JQIamo/Low-noise-5A-power-supply/README.md

# Low-noise-5A-power-supply
5A low noise +-15 V power supply for Eurocard boxes
