JQIamo/Low-noise-5A-power-supply/EurocardPowerSupply_mods.brd

## EAGLE design EurocardPowerSupply_mods.brd (2017-11-13)

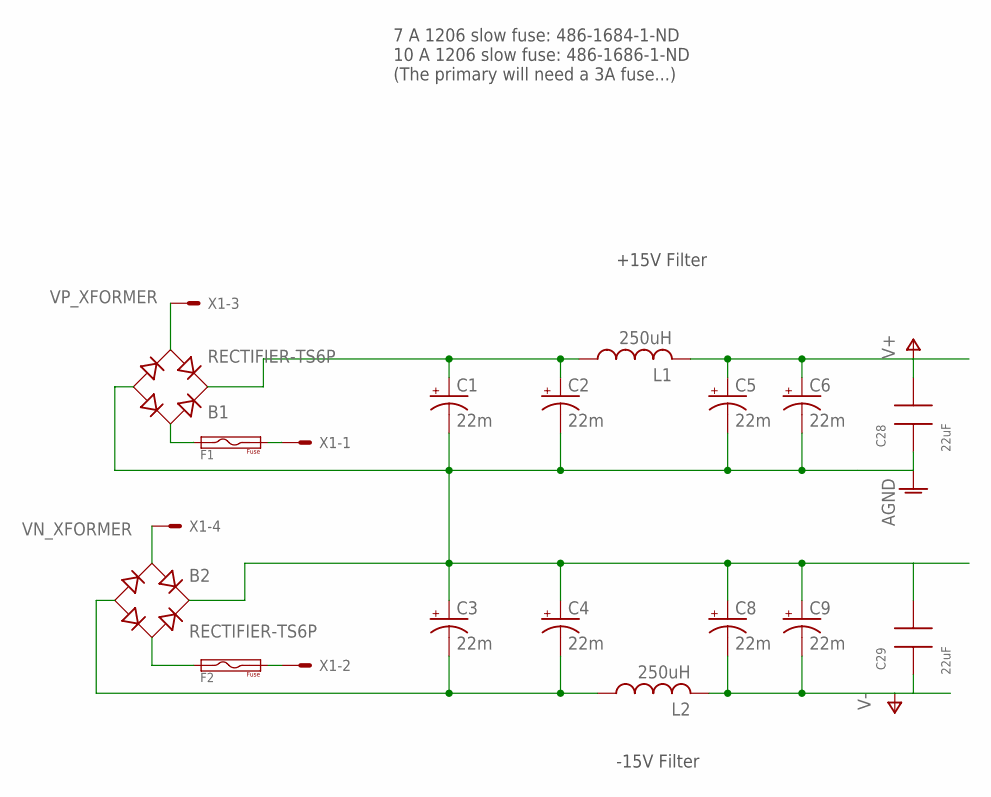
[picture p1: schematic EurocardPowerSupply_mods.sch, sheet 1]

Parts:
B1, B2: RECTIFIER-TS6P; TS6P
C1, C2, C3, C4, C5, C6, C8, C9: 22m; EB35D
C28, C29: 22uF; 1206; DIGIKEY 445-8045-1-ND
F1, F2: FUSE1206; DIGIKEY 486-1686-1-ND
L1, L2: 250uH; 5721-RC
X1: 5566-4

Connections:
AGND: B1.-, B2.+, C1.-, C2.-, C3.+, C4.+, C5.-, C6.-, C8.+, C9.+, C28.1, C29.2; also elsewhere on the board
unnamed: B1.AC1, F1.1
unnamed: F1.2, X1.1
unnamed: F2.2, X1.2
unnamed: B2.AC2, F2.1
V+: C5.+, C6.+, C28.2, L1.P$2 (2); also elsewhere on the board
V-: C8.-, C9.-, C29.1, L2.P$2 (2); also elsewhere on the board
VN_RECT: B2.-, C3.-, C4.-, L2.P$1 (1); also elsewhere on the board
VN_XFORMER: B2.AC1, X1.4
VP_RECT: B1.+, C1.+, C2.+, L1.P$1 (1); also elsewhere on the board
VP_XFORMER: B1.AC2, X1.3

Notes on the sheet:
-15V Filter
+15V Filter
7 A 1206 slow fuse: 486-1684-1-ND 10 A 1206 slow fuse: 486-1686-1-ND (The primary will need a 3A fuse...)

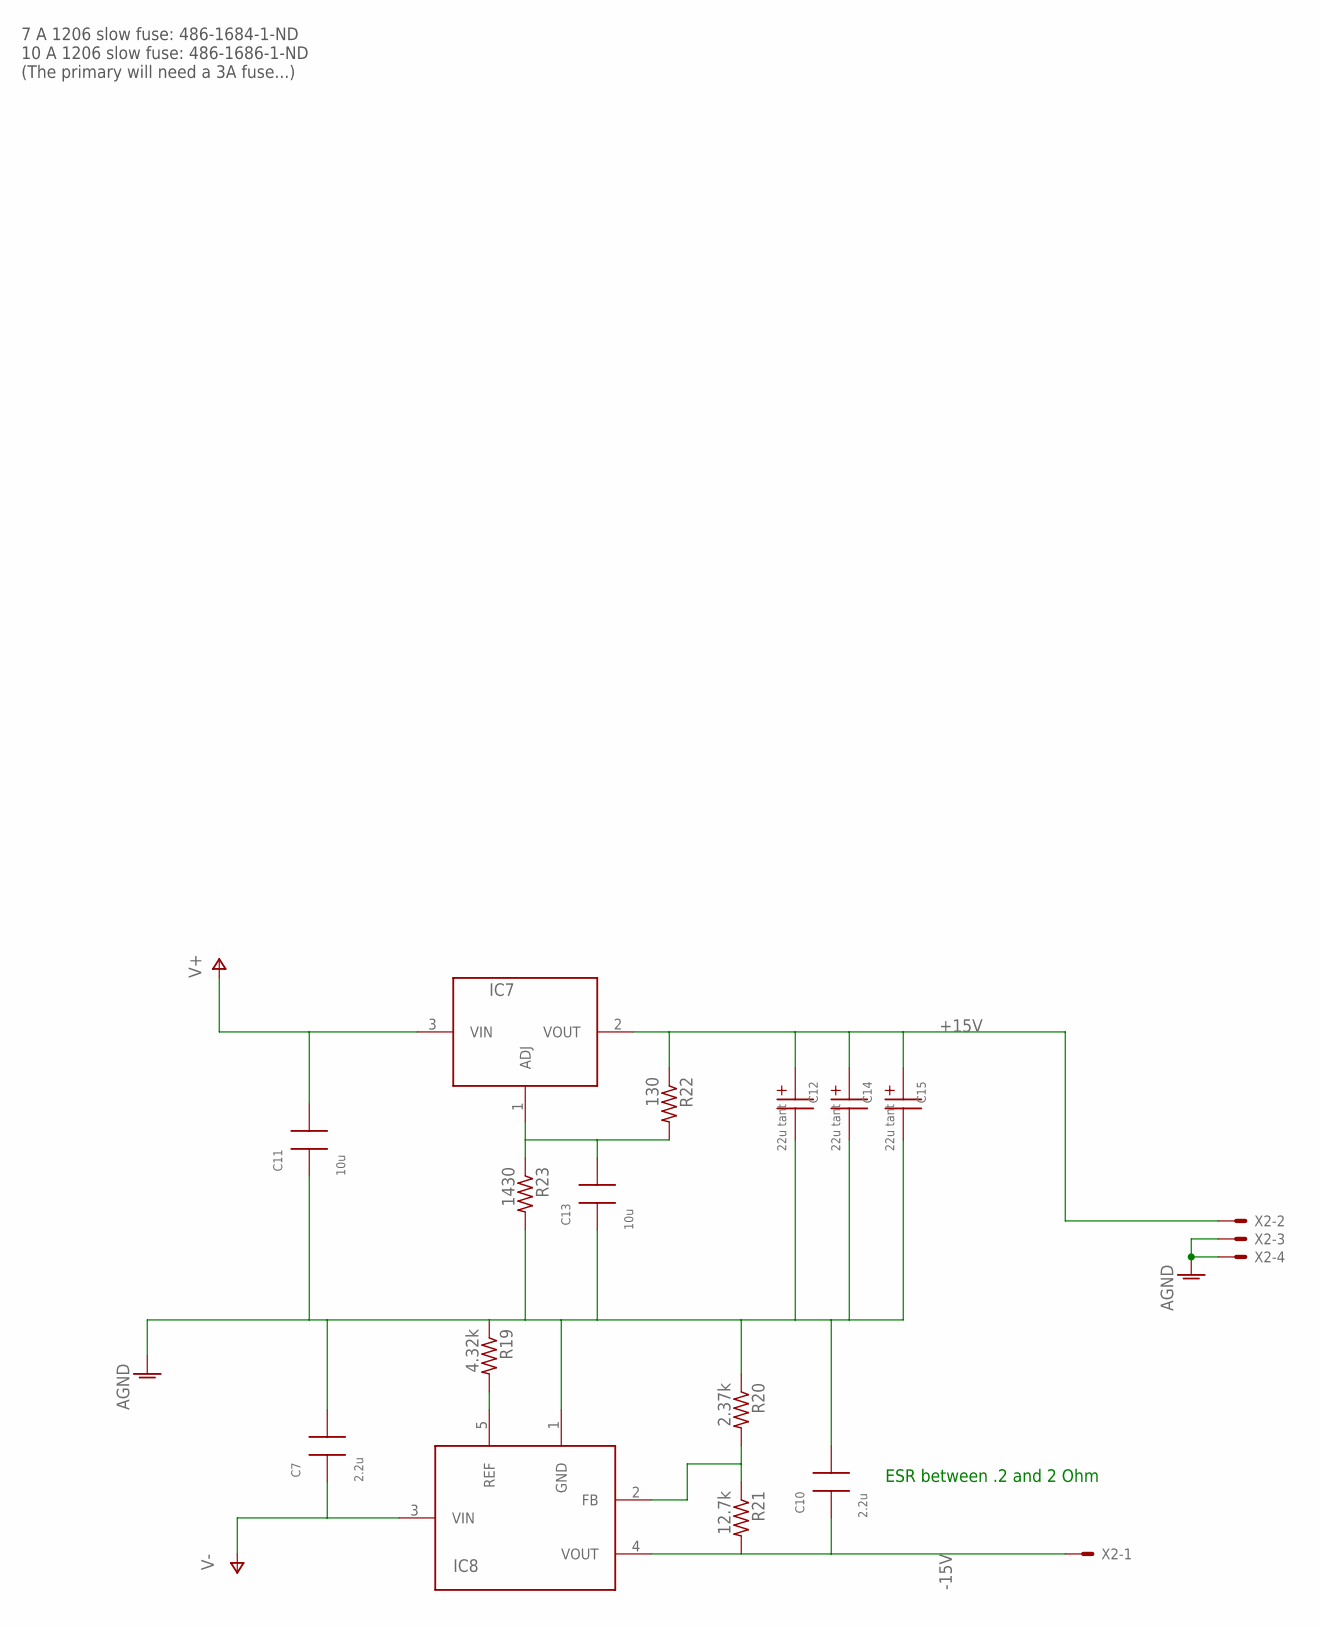
[picture p2: schematic EurocardPowerSupply_mods.sch, sheet 2]

Parts:
C7, C10: 2.2u; 1206; DIGIKEY 399-1249-1-ND
C11, C13: 10u; 1206; DIGIKEY 399-1249-1-ND
C12, C14, C15: 22u tant; 1206P; DIGIKEY 399-1249-1-ND
IC7: LM1084TO220; T03B
IC8: LT1185TO220/INLINE; T05A
R19: 4.32k; R1206; DIGIKEY 541-1.5KECT-ND
R20: 2.37k; R1206; DIGIKEY 541-1.5KECT-ND
R21: 12.7k; R1206; DIGIKEY 541-1.5KECT-ND
R22: 130; R1206; DIGIKEY 541-1.5KECT-ND
R23: 1430; R1206; DIGIKEY 541-1.5KECT-ND
X2: 5566-4

Connections:
+15V: C12.1, C14.1, C15.1, IC7.2 (VOUT), R22.1, X2.2
-15V: C10.1, IC8.4 (VOUT), R21.2, X2.1
AGND: C7.2, C10.2, C11.1, C12.2, C13.1, C14.2, C15.2, IC8.1 (GND), R19.1, R20.1, R23.2, X2.3, X2.4; also elsewhere on the board
unnamed: IC8.2 (FB), R20.2, R21.1
unnamed: C13.2, IC7.1 (ADJ), R22.2, R23.1
unnamed: IC8.5 (REF), R19.2
V+: C11.2, IC7.3 (VIN); also elsewhere on the board
V-: C7.1, IC8.3 (VIN); also elsewhere on the board

Notes on the sheet:
7 A 1206 slow fuse: 486-1684-1-ND 10 A 1206 slow fuse: 486-1686-1-ND (The primary will need a 3A fuse...)
ESR between .2 and 2 Ohm

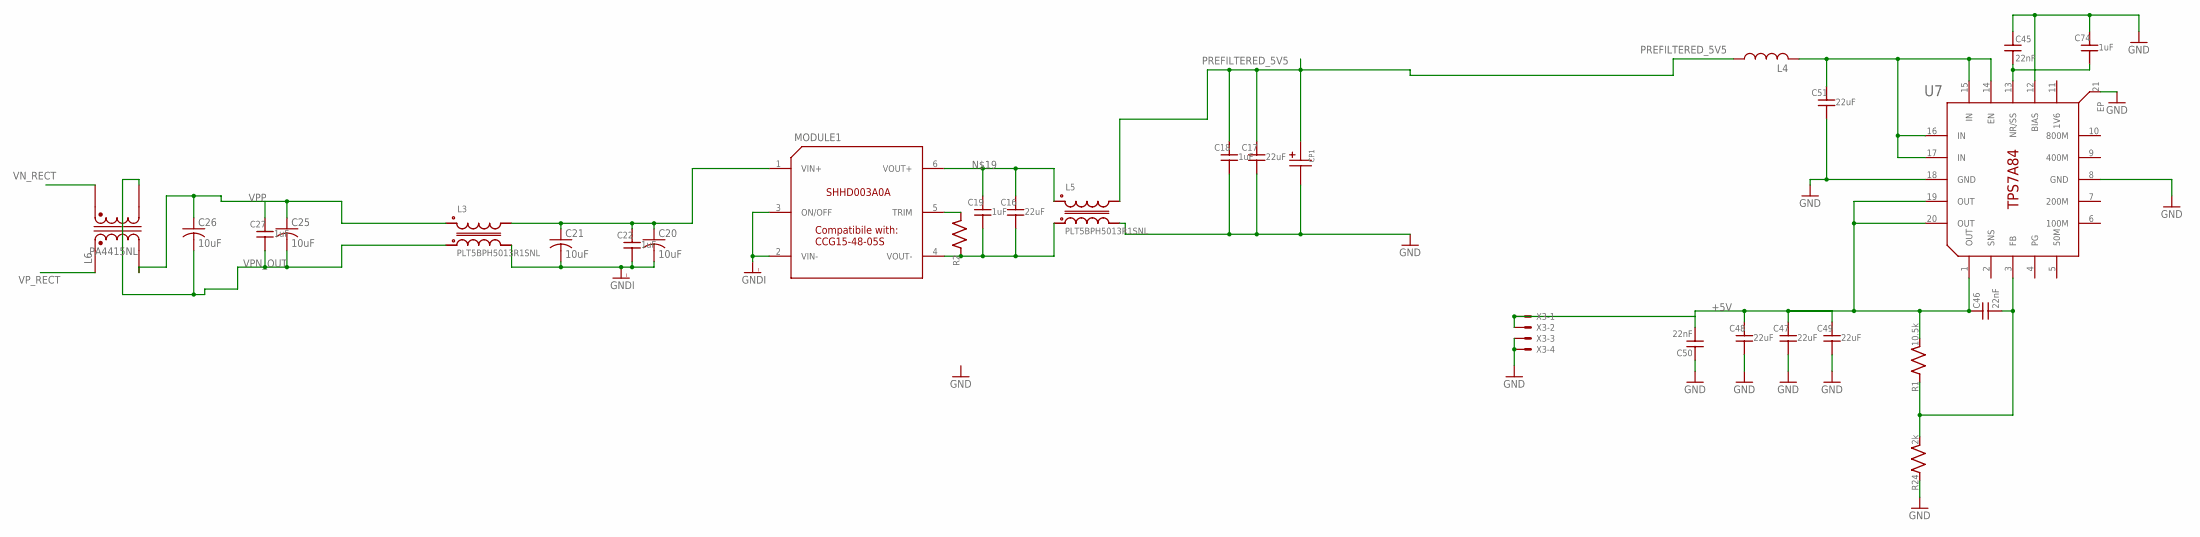
[picture p3: schematic EurocardPowerSupply_mods.sch, sheet 3]

Parts:
C16, C17, C47, C48, C49, C51: 22uF; C_MLCC_0805; DIGIKEY 445-9112-1-ND
C18, C19, C22, C27, C74: 1uF; C_MLCC_0805; DIGIKEY 587-5018-1-ND
C20, C21, C25, C26: 10uF; C2220K; DIGIKEY 445-7947-1-ND
C45, C46, C50: 22nF; C_MLCC_0306; DIGIKEY 490-4317-1-ND
CP1: CAP-POLPANASONIC_F; PANASONIC_F
L3, L5: PLT5BPH5013R1SNL; MURATA_CM_CHOKE_PLT5BPH_SERIES; MPN PLT5BPH5013R1SNL; DIGIKEY 490-10979-1-ND
L4: MURATA_NFZ5BBW100LN10L; MURATA_1MHZ_3A_FERRITE; DIGIKEY 490-12168-1-ND
L6: PA4415NL
MODULE1: GE_SHHD003A0A; GE_SHHD003A0A_THROUGH_HOLE; DIGIKEY 285-2609-ND
R1: 10.5k; R_0805; DIGIKEY 10.5k
R2: R_SMDR0805; R_0805
R24: 2k; R_0805; DIGIKEY RR12P2.0KDCT-ND
U7: TEXAS_INSTRUMENTS_TPS7A84; S-PVQFN-N20; DIGIKEY 296-43749-1-ND
X3: 5566-4

Connections:
+5V: C46.P$1 (1), C47.P$1 (1), C48.P$1 (1), C49.P$1 (1), C50.P$2 (2), R1.P$2 (2), U7.1 (OUT), U7.19 (OUT), U7.20 (OUT), X3.1, X3.2
GND: C17.P$2 (2), C18.P$2 (2), C45.P$1 (1), C47.P$2 (2), C48.P$2 (2), C49.P$2 (2), C50.P$1 (1), C51.P$2 (2), C74.P$1 (1), CP1.-, L5.P$3 (3), R24.P$1 (1), U7.8 (GND), U7.12 (BIAS), U7.18 (GND), U7.21 (EP), X3.3, X3.4
GNDI: C20.2, C21.2, C22.P$2 (2), L3.P$3 (3), MODULE1.2 (VIN-), MODULE1.3 (ON/OFF)
unnamed: C16.P$2 (2), C19.P$2 (2), L5.P$4 (1), MODULE1.4 (VOUT-), R2.P$1 (1)
unnamed: MODULE1.5 (TRIM), R2.P$2 (2)
unnamed: C16.P$1 (1), C19.P$1 (1), L5.P$1 (2), MODULE1.6 (VOUT+)
unnamed: C45.P$2 (2), C74.P$2 (2), U7.13 (NR/SS)
unnamed: C46.P$2 (2), R1.P$1 (1), R24.P$2 (2), U7.3 (FB)
unnamed: C51.P$1 (1), L4.P$2 (2), U7.14 (EN), U7.15 (IN), U7.16 (IN), U7.17 (IN)
PREFILTERED_5V5: C17.P$1 (1), C18.P$1 (1), CP1.+, L4.P$1 (1), L5.P$2 (4)
VN_RECT: L6.2; also elsewhere on the board
VPN_OUT: C25.2, C26.2, C27.P$2 (2), L3.P$4 (1), L6.3 (4)
VPP: C25.1, C26.1, C27.P$1 (1), L3.P$1 (2), L6.4 (3)
VPPI: C20.1, C21.1, C22.P$1 (1), L3.P$2 (4), MODULE1.1 (VIN+)
VP_RECT: L6.1; also elsewhere on the board

Notes on the sheet:
Compatibile with: CCG15-48-05S

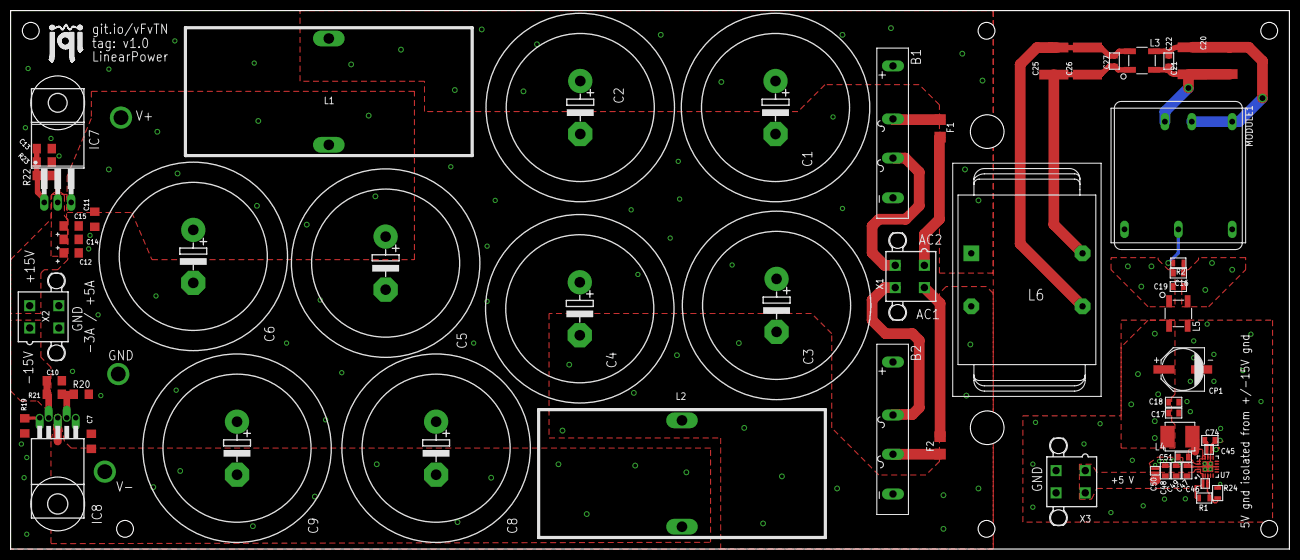
[picture p4: board EurocardPowerSupply_mods.brd from above]

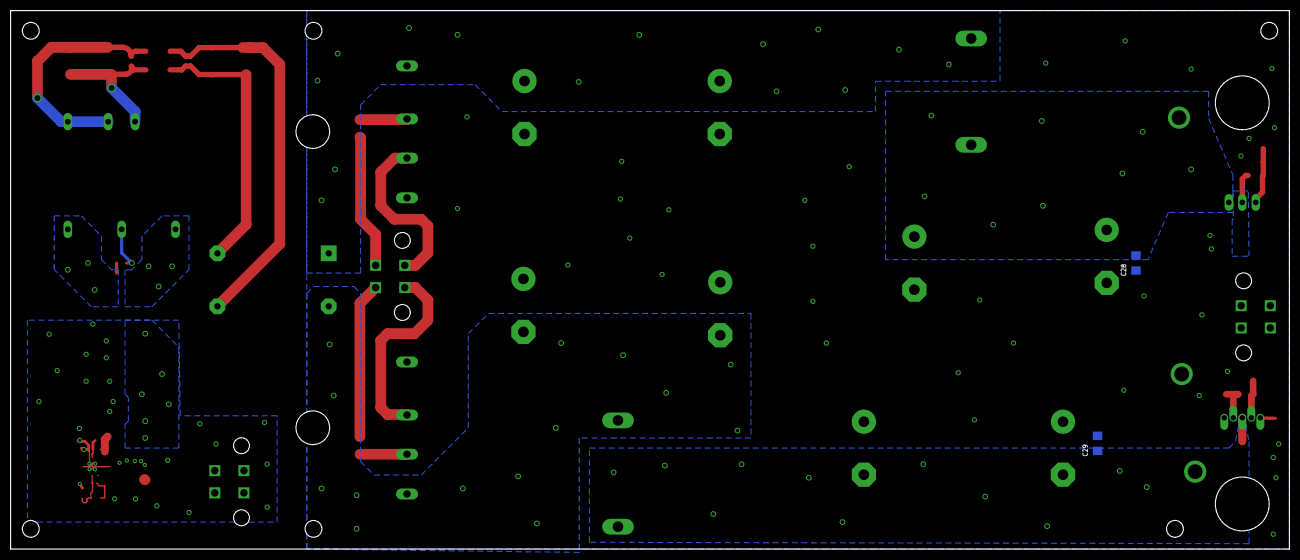
[picture p5: board EurocardPowerSupply_mods.brd from below]

Board: 2 copper layers, 241.3 x 101.6 mm, 62 parts (2 on the bottom side), 29 nets.

Other parts of the board:
U$1: JQI_LOGO_POSITIVE-SILKSCREEN
