JQIamo/Low-noise-5A-power-supply/Voltage Reg Comparison.brd

## EAGLE design Voltage Reg Comparison.brd (2015-11-11)

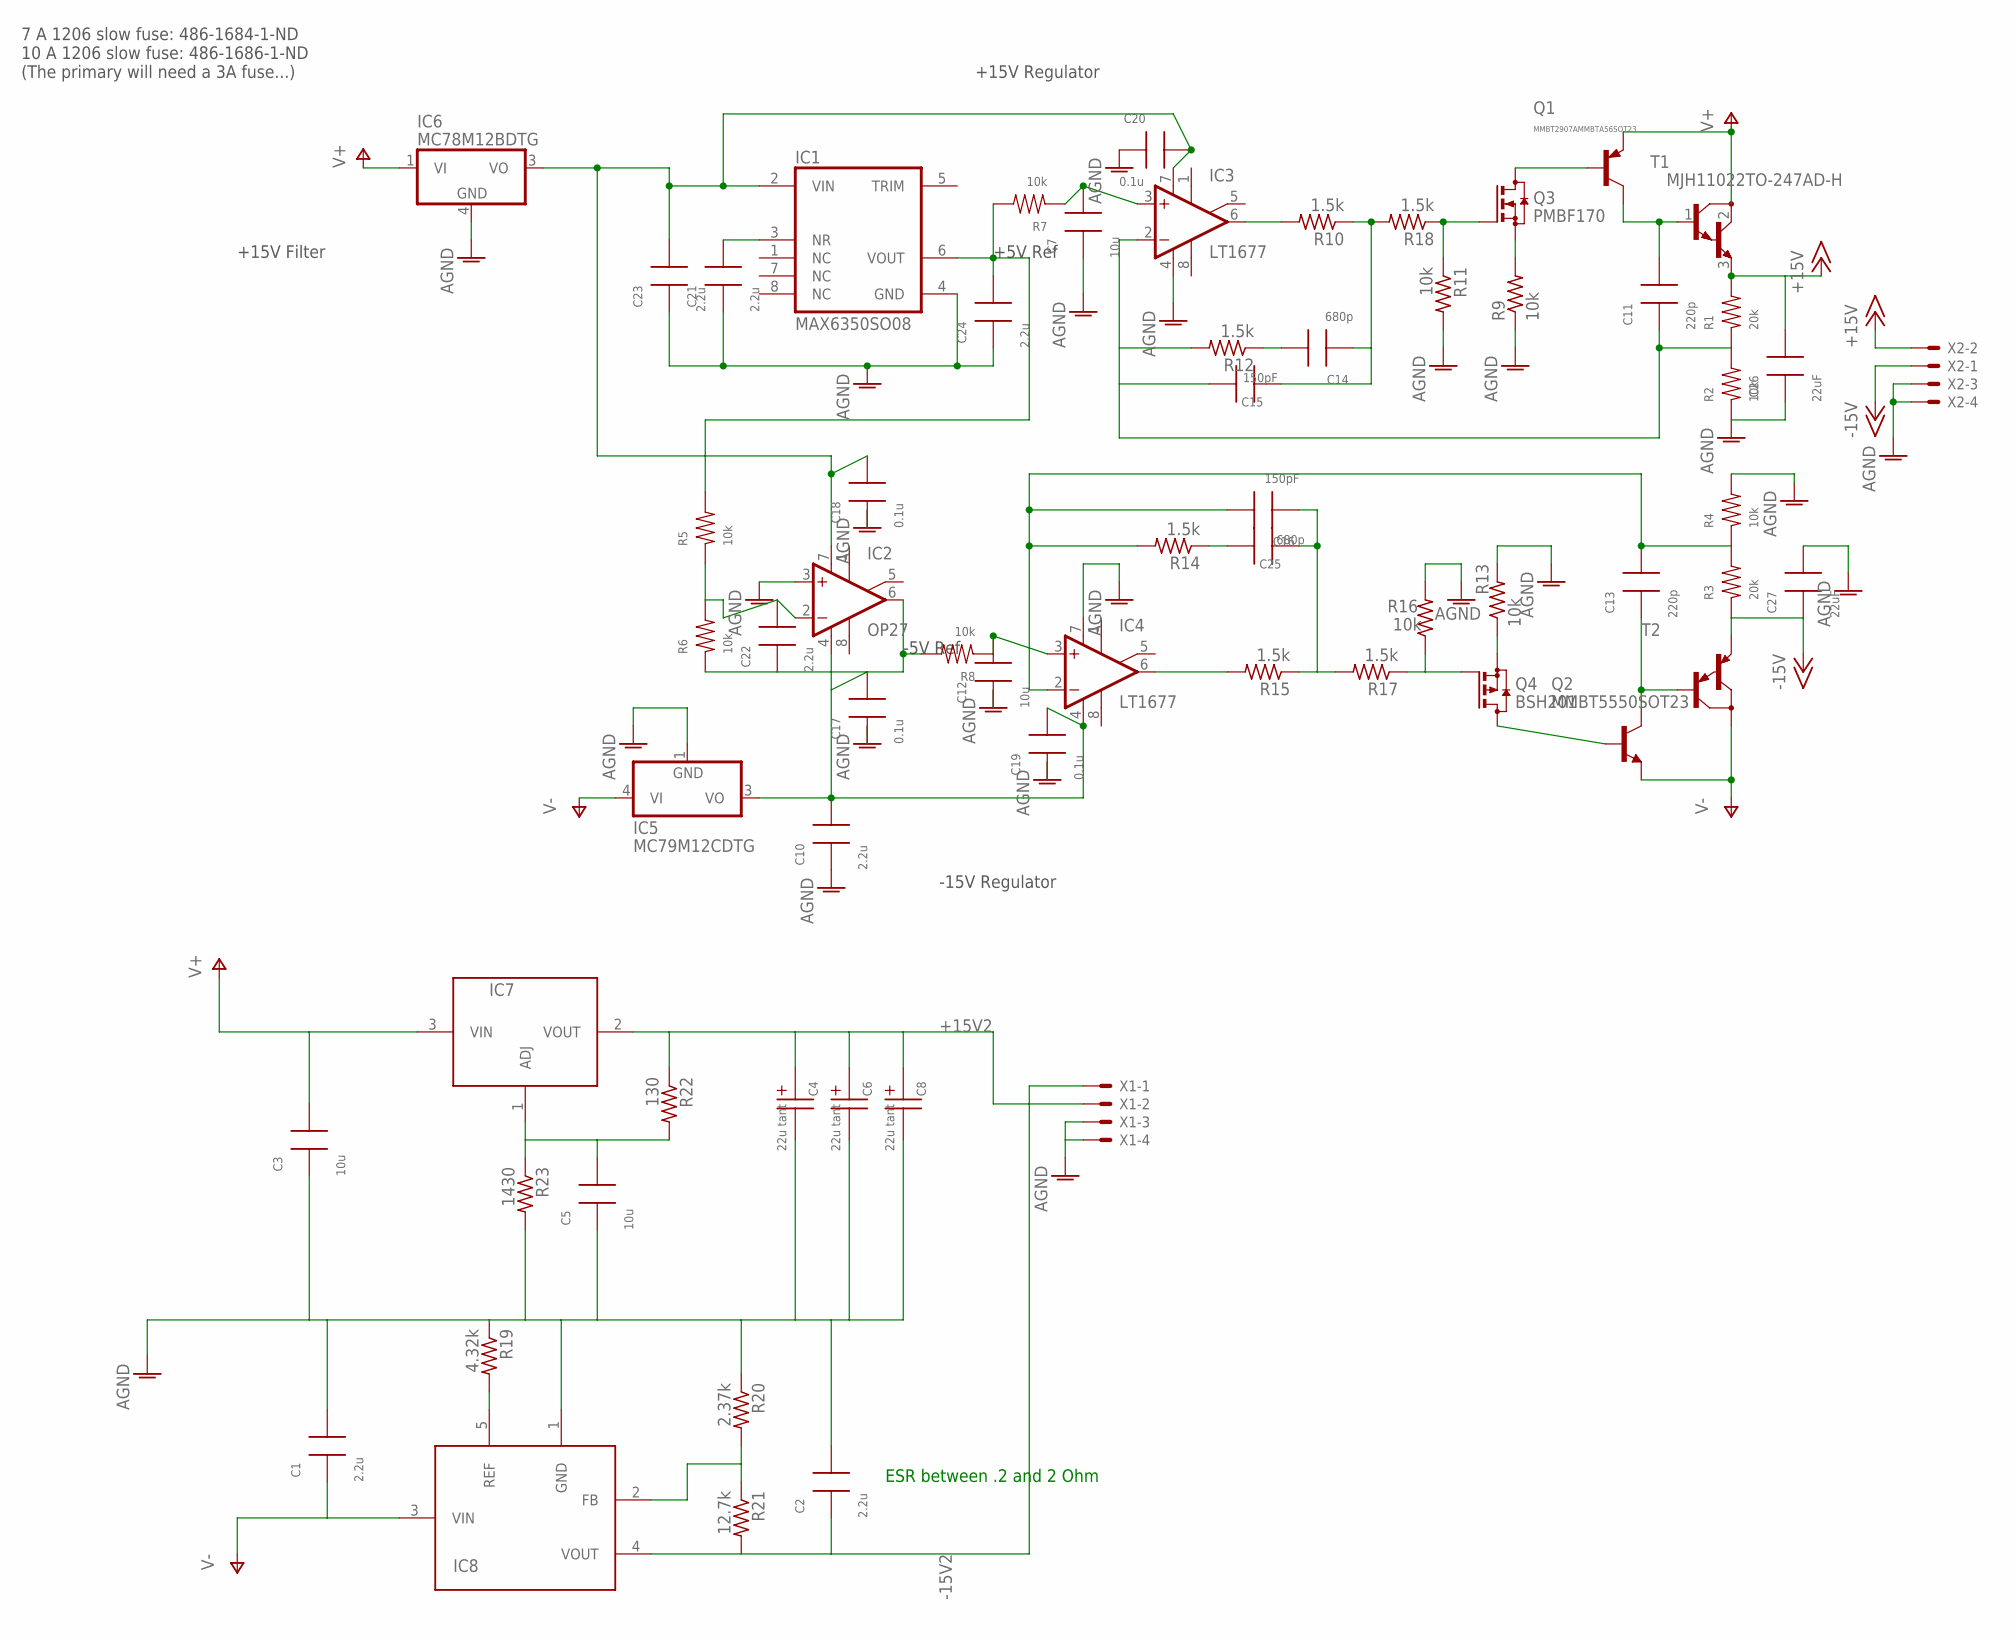
[picture p6: schematic Voltage Reg Comparison.sch]

Parts:
C1, C2: 2.2u; 1206; DIGIKEY 399-1249-1-ND
C3, C5: 10u; 1206; DIGIKEY 399-1249-1-ND
C4, C6, C8: 22u tant; 1206P; DIGIKEY 399-1249-1-ND
C7, C12: 10u; 1206; DIGIKEY 445-12883-2-ND
C10, C21, C22, C23, C24: 2.2u; 1206; DIGIKEY 587-2402-1-ND
C11, C13: 220p; 1206; DIGIKEY 1276-1166-1-ND
C14, C25: 680p; 1206; DIGIKEY 399-8209-1-ND
C15, C16: 150pF; 1206
C17, C18, C19, C20: 0.1u; 1206; DIGIKEY 399-1249-1-ND
C26, C27: 22uF; 1206; DIGIKEY 445-8045-1-ND
IC1: MAX6350SO08; SO08
IC2: OP27; SO08; DIGIKEY OP27GSZ-REEL7CT-ND
IC3, IC4: LT1677; SO08; DIGIKEY LT1677CS8#PBF-ND
IC5: MC79M12CDTG; DPACK_3; DIGIKEY MC79M12CDTGOS-ND
IC6: MC78M12BDTG; DPACK_3; DIGIKEY MC78M12BDTGOS-ND
IC7: LM1084TO220; T03B
IC8: LT1185TO220/INLINE; T05A
Q1: MMBT2907AMMBTA56SOT23; SOT23
Q2: MMBT5550SOT23; SOT23; DIGIKEY MMBT5550CT-ND
Q3: PMBF170; SOT23; DIGIKEY MMBT2907AFSCT-ND
Q4: BSH201; SOT23; DIGIKEY 568-6217-1-ND
R1, R3: 20k; 1206; DIGIKEY RMCF1206FT20K0CT-ND
R2, R4, R5, R6, R7, R8: 10k; 1206; DIGIKEY RNCP1206FTD10K0CT-ND
R9, R13: 10k; R1206; DIGIKEY RNCP1206FTD10K0CT-ND
R10, R12, R14, R15, R17, R18: 1.5k; R1206; DIGIKEY 541-1.5KECT-ND
R11, R16: 10k; R1206; DIGIKEY 541-1.5KECT-ND
R19: 4.32k; R1206; DIGIKEY 541-1.5KECT-ND
R20: 2.37k; R1206; DIGIKEY 541-1.5KECT-ND
R21: 12.7k; R1206; DIGIKEY 541-1.5KECT-ND
R22: 130; R1206; DIGIKEY 541-1.5KECT-ND
R23: 1430; R1206; DIGIKEY 541-1.5KECT-ND
T1: MJH11022TO-247AD-H; TO-247AD-H
T2: MJH11021TO-247AD-H; TO-247AD-H
X1, X2: 5566-4RA; 5566-4-RA

Connections:
+12V: C18.2, C20.2, C23.2, IC1.2 (VIN), IC2.7 (V+), IC3.7 (V+), IC6.3 (VO)
+15V: C26.2, R1.2, T1.3 (E), X2.2
+15V2: C4.1, C6.1, C8.1, IC7.2 (VOUT), R22.1, X1.2
-12V: C10.2, C17.2, C19.2, IC2.4 (V-), IC4.4 (V-), IC5.3 (VO)
-15V: C27.1, R3.1, T2.3 (E), X2.1
-15V2: C2.1, IC8.4 (VOUT), R21.2, X1.1
AGND: C1.2, C2.2, C3.1, C4.2, C5.1, C6.2, C7.1, C8.2, C10.1, C12.1, C17.1, C18.1, C19.1, C20.1, C21.1, C23.1, C24.1, C26.1, C27.2, IC1.4 (GND), IC2.3 (+IN), IC3.4 (V-), IC4.7 (V+), IC5.1 (GND), IC6.4 (GND), IC8.1 (GND), R2.1, R4.2, R9.1, R11.2, R13.2, R16.2, R19.1, R20.1, R23.2, X1.3, X1.4, X2.3, X2.4
unnamed: IC8.2 (FB), R20.2, R21.1
unnamed: C5.2, IC7.1 (ADJ), R22.2, R23.1
unnamed: C21.2, IC1.3 (NR)
unnamed: C24.2, IC1.6 (VOUT), R5.2, R7.2
unnamed: C14.2, R12.1
unnamed: C13.1, Q2.3 (C), T2.1 (B)
unnamed: IC3.6 (OUT), R10.2
unnamed: Q4.1 (G), R16.1, R17.1
unnamed: C11.2, Q1.3 (C), T1.1 (B)
unnamed: C22.2, IC2.2 (-IN), R5.1, R6.2
unnamed: C22.1, IC2.6 (OUT), R6.1, R8.2
unnamed: Q4.2 (S), R13.1
unnamed: C11.1, C15.2, IC3.2 (-IN), R1.1, R2.2, R12.2
unnamed: IC4.6 (OUT), R15.2
unnamed: C7.2, IC3.3 (+IN), R7.1
unnamed: Q2.1 (B), Q4.3 (D)
unnamed: C12.2, IC4.3 (+IN), R8.1
unnamed: IC8.5 (REF), R19.2
unnamed: C13.2, C16.2, IC4.2 (-IN), R3.2, R4.1, R14.2
unnamed: Q3.1 (G), R11.1, R18.1
unnamed: C25.2, R14.1
unnamed: C16.1, C25.1, R15.1, R17.2
unnamed: Q1.1 (B), Q3.3 (D)
unnamed: Q3.2 (S), R9.2
unnamed: C14.1, C15.1, R10.1, R18.2
V+: IC6.1 (VI), Q1.2 (E), T1.2 (C)
V+2: C3.2, IC7.3 (VIN)
V-: IC5.4 (VI), Q2.2 (E), T2.2 (C)
V-2: C1.1, IC8.3 (VIN)

Notes on the sheet:
+5V Ref
-5V Ref
+15V Regulator
-15V Regulator
+15V Filter
7 A 1206 slow fuse: 486-1684-1-ND 10 A 1206 slow fuse: 486-1686-1-ND (The primary will need a 3A fuse...)
ESR between .2 and 2 Ohm

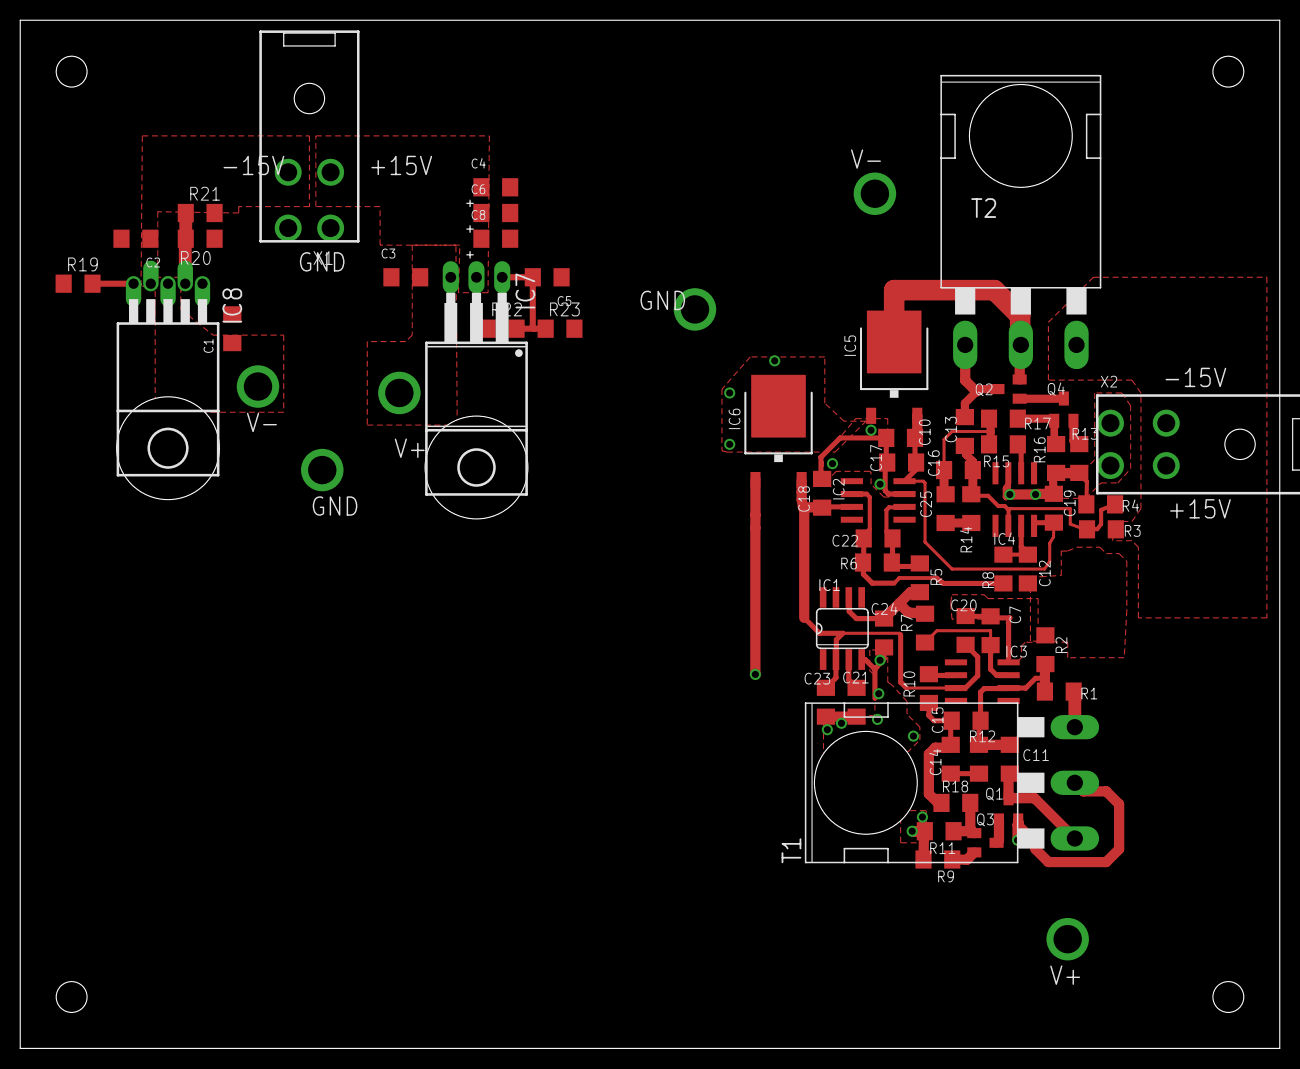
[picture p7: board Voltage Reg Comparison.brd from above]

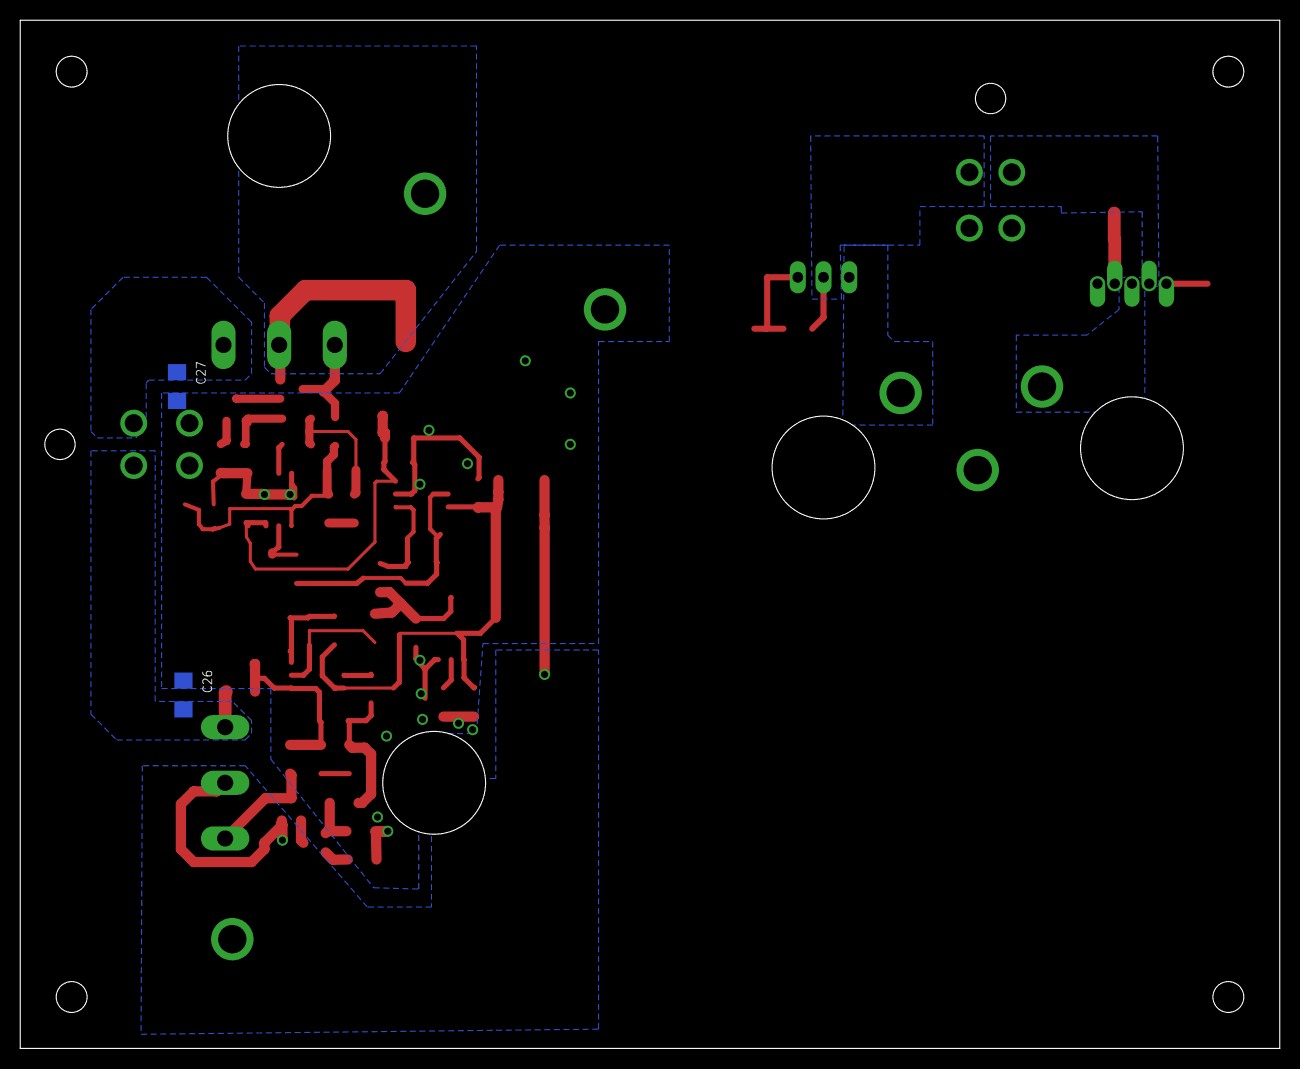
[picture p8: board Voltage Reg Comparison.brd from below]

Board: 4 copper layers, 124.5 x 101.6 mm, 65 parts (2 on the bottom side), 36 nets.
