JQIamo/Low-noise-5A-power-supply/Low Noise PS Filter Only.brd

## EAGLE design Low Noise PS Filter Only.brd (2015-11-11)

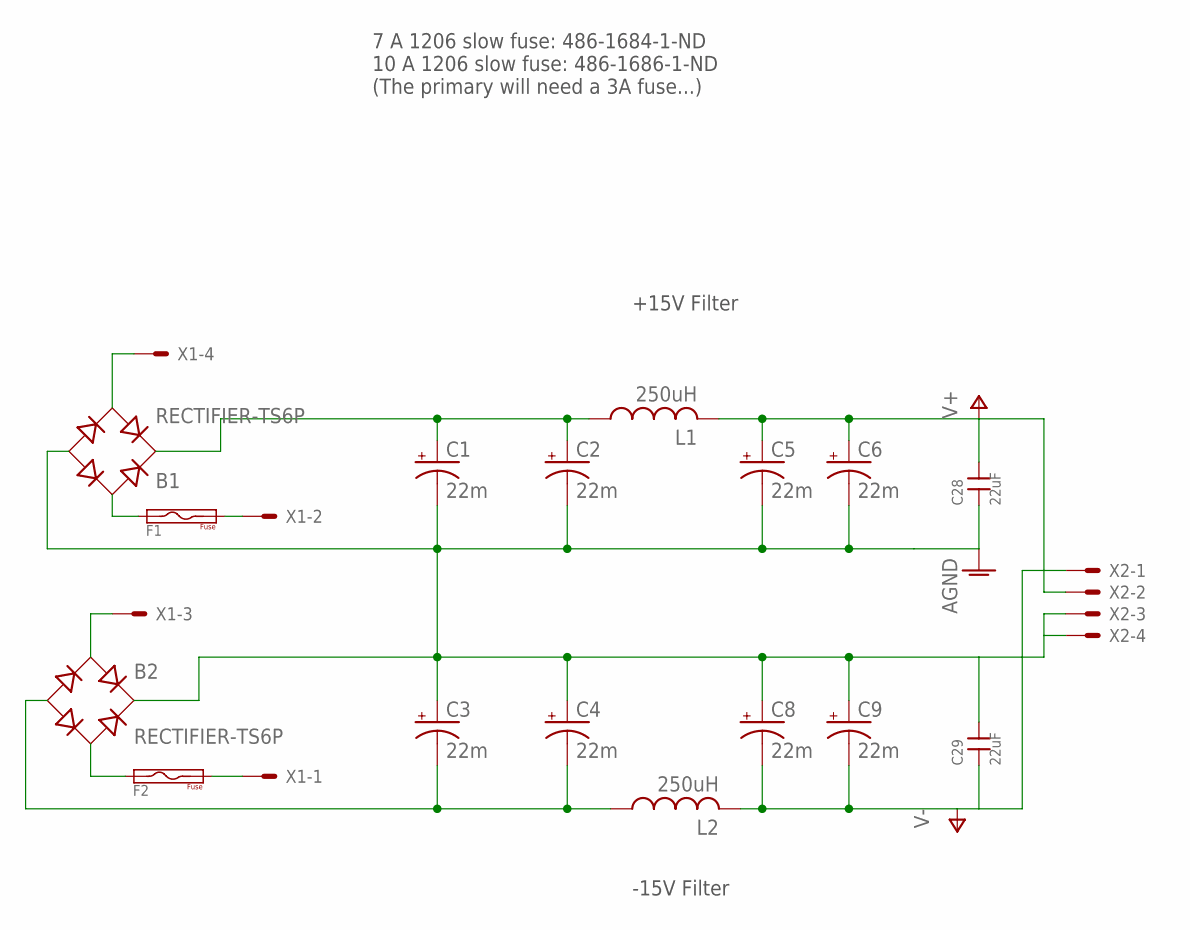
[picture p9: schematic Low Noise PS Filter Only.sch]

Parts:
B1, B2: RECTIFIER-TS6P; TS6P
C1, C2, C3, C4, C5, C6, C8, C9: 22m; EB35D
C28, C29: 22uF; 1206; DIGIKEY 445-8045-1-ND
F1, F2: FUSE1206; DIGIKEY 486-1686-1-ND
L1, L2: 250uH; 5721-RC
X1, X2: 5566-4

Connections:
AGND: B1.-, B2.+, C1.-, C2.-, C3.+, C4.+, C5.-, C6.-, C8.+, C9.+, C28.1, C29.2, X2.3, X2.4
unnamed: B1.AC1, F1.1
unnamed: B1.AC2, X1.4
unnamed: B1.+, C1.+, C2.+, L1.P$1 (1)
unnamed: B2.AC1, X1.3
unnamed: F1.2, X1.2
unnamed: F2.2, X1.1
unnamed: B2.-, C3.-, C4.-, L2.P$1 (1)
unnamed: B2.AC2, F2.1
V+: C5.+, C6.+, C28.2, L1.P$2 (2), X2.2
V-: C8.-, C9.-, C29.1, L2.P$2 (2), X2.1

Notes on the sheet:
-15V Filter
+15V Filter
7 A 1206 slow fuse: 486-1684-1-ND 10 A 1206 slow fuse: 486-1686-1-ND (The primary will need a 3A fuse...)

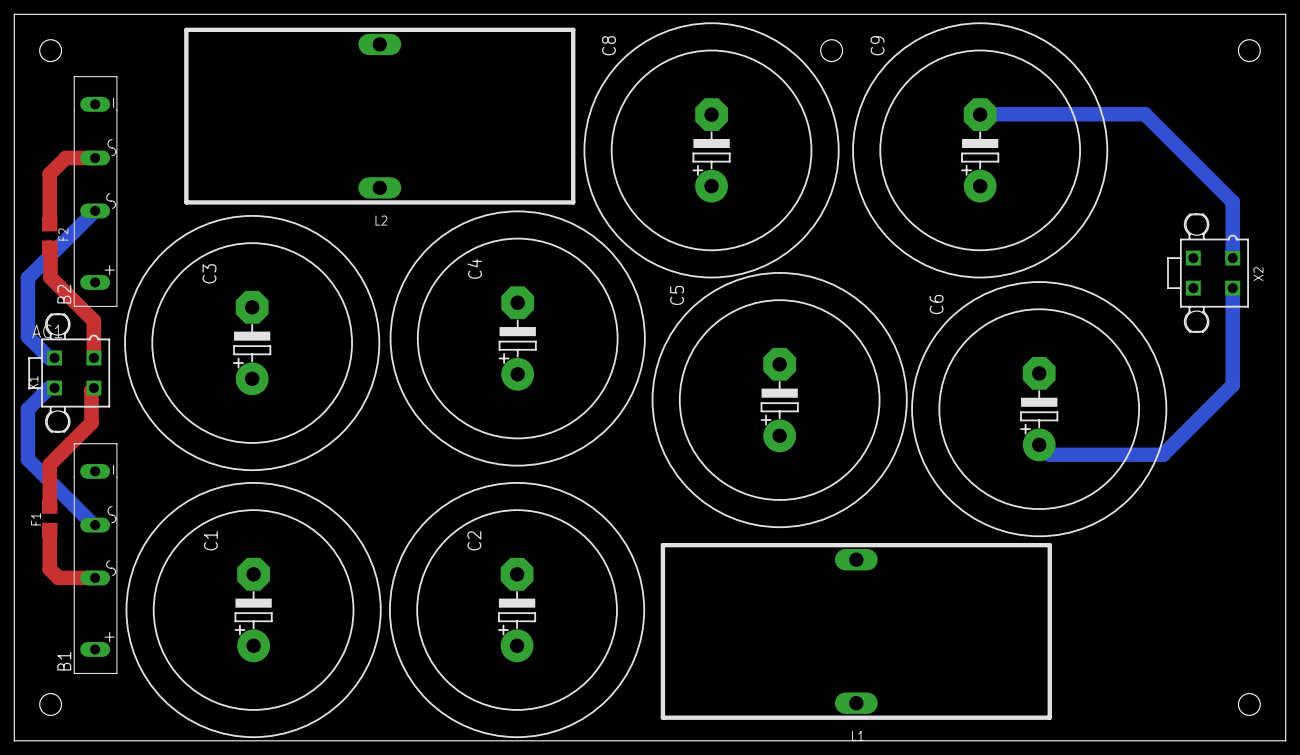
[picture p10: board Low Noise PS Filter Only.brd from above]

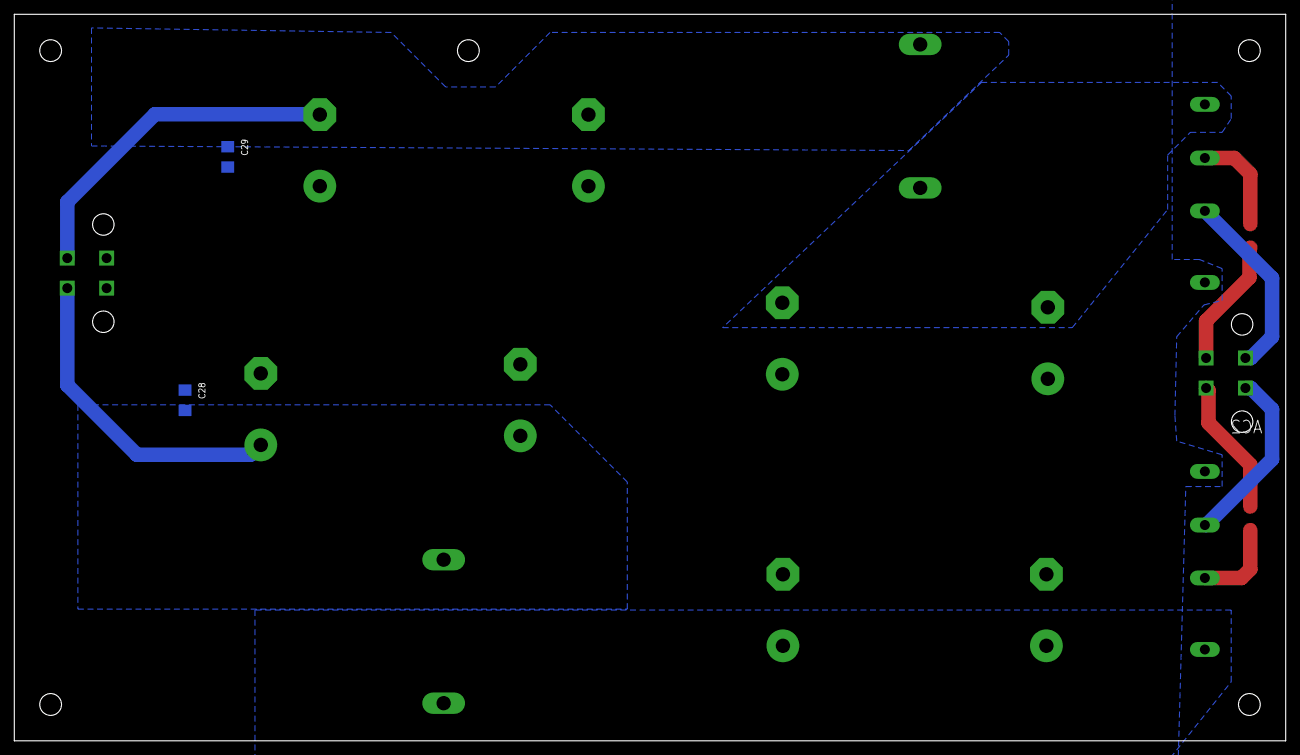
[picture p11: board Low Noise PS Filter Only.brd from below]

Board: 4 copper layers, 177.8 x 101.6 mm, 18 parts (2 on the bottom side), 11 nets.
