JQIamo/Low-noise-5A-power-supply/(commit log)

2015-03-24 Setting up the correct files and directories
    [Low Noise PS Bottom SMD.brd, Low Noise PS Bottom SMD.sch]
2015-03-26 Intermediate version
    More work is still required
    [Low Noise PS Bottom SMD.brd, Low Noise PS Bottom SMD.sch]
2015-04-02 Almost ready to print
    1) "cosmetic" adjustments needed (mainly increasing clearance for traces
    below SMD parts)
    2) component values need to be adjusted and chosen
    3) Silkscreen needs to be cleaned
    [Low Noise PS.brd, Low Noise PS.sch]
2015-04-06 Version for LPKF printing.
    Most resistor/capacitor values are not final.
    [Low Noise PS.brd]
2015-04-14 BOM and part attributes adjusted
    This commit is not quite the final one: a performance test must be done
    before putting it into production. Also it might be useful to reorder
    part names to make assembly easy.
    [BOM_with_no_transformer.csv, Low Noise PS.brd, Low Noise PS.sch]
2015-04-21 Change in component values. Not final version!
    After assembling commit 290fa40aa6a372085 the board oscillates.
    Changing all DNP resistors and all 0 Ohm resistors to 1.5K Ohm makes the
    positive regulator stable under 6 Ohm load. The negative section is
    still unstable. Some final value adjustment will be required to ensure
    unconditional stability (with enough margin to account for the variation
    of capacitor values with temperature.
    [BOM_with_no_transformer.csv, Low Noise PS.brd, Low Noise PS.sch]
2015-04-21 Moved capacitor
    To avoid collision with transistor on the bottom side.
    Also a resistor has been rotated to reduce a trace lenght
    [Low Noise PS.brd]
2015-11-11 Swap pin 3/4 on Right Angle Molex, add Vreg ICs to library
2015-11-11 Add board to test a slightly different filter configuration
    [Low Noise PS Filter Only.brd, Low Noise PS Filter Only.sch]
2015-11-11 Add board to compare custom V. Reg. vs IC solution
    [Voltage Reg Comparison.brd, Voltage Reg Comparison.sch]
2017-11-13 v1.0 production
    [EurocardPowerSupply.brd, EurocardPowerSupply.sch, EurocardPowerSupply_mods.brd, EurocardPowerSupply_mods.sch]
